blueacro/reefvolt-sensorbuddy/hardware/drycontact/docs/images/pcb-3d-bottom.png

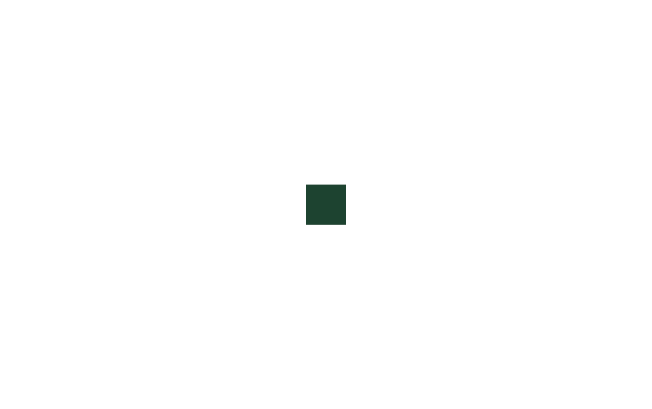
hardware/drycontact/docs/images/pcb-3d-bottom.png
