blueacro/reefvolt-sensorbuddy/hardware/drycontact/mcu.kicad_sch

## KiCad design hardware/drycontact/mcu.kicad_sch (2026-07-04)

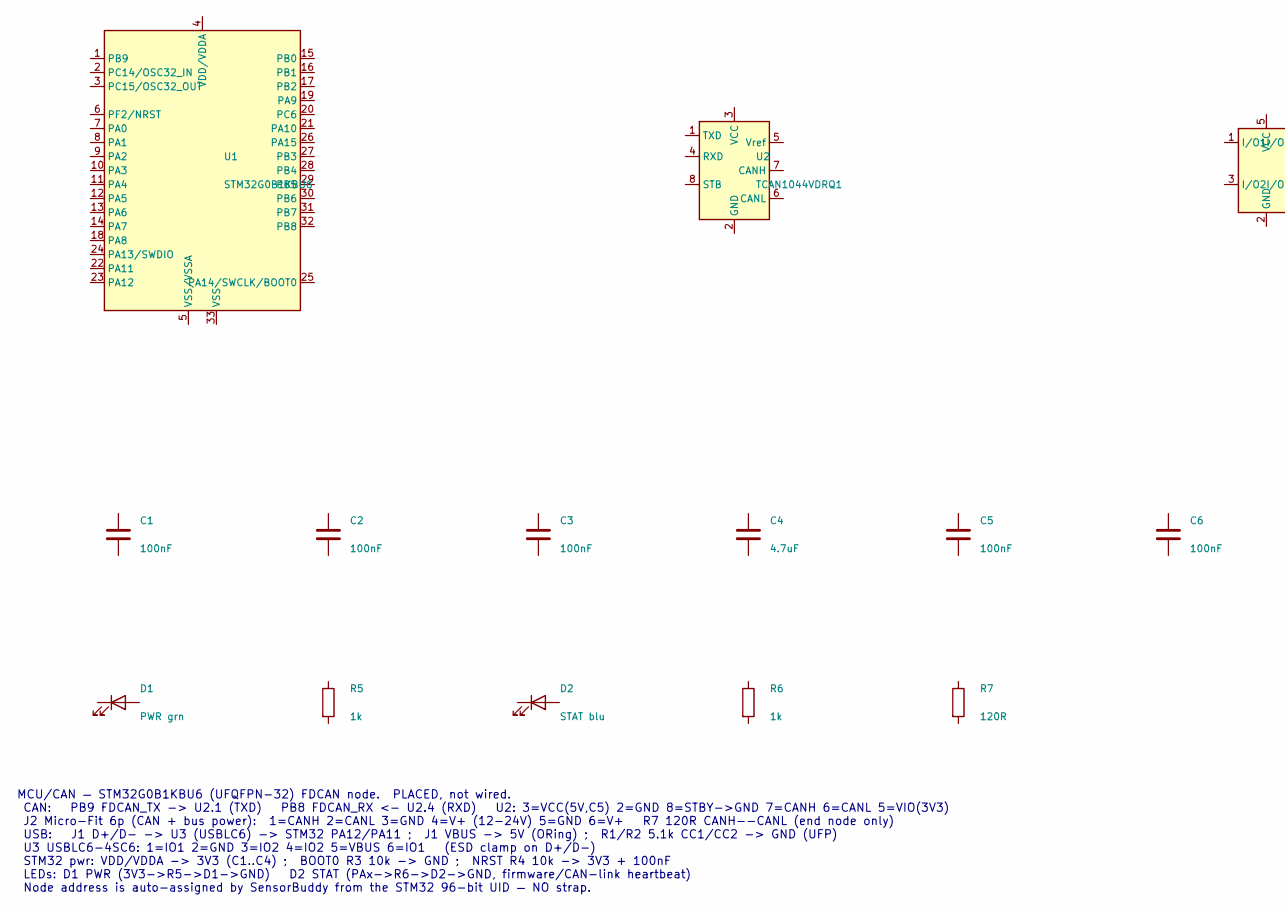
[picture p2: schematic mcu.kicad_sch, part in row 1, column 1]

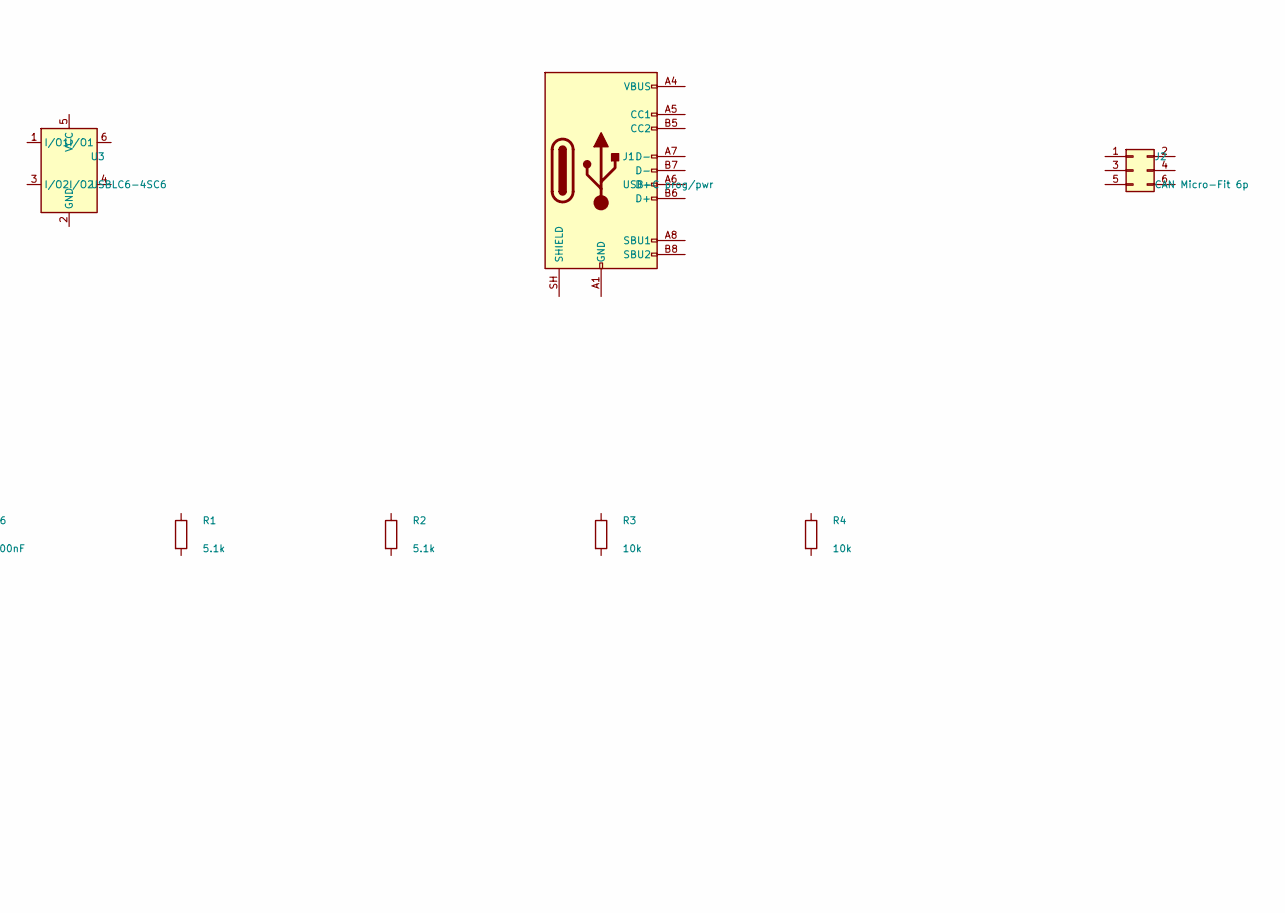
[picture p3: schematic mcu.kicad_sch, part in row 1, column 2]

Parts:
C1, C2, C3, C5, C6: 100nF; C_0402_1005Metric; LCSC C1525
C4: 4.7uF; C_0805_2012Metric; LCSC C1611
D1: PWR grn; LED_0402_1005Metric; MPN KT-0402G; LCSC C72043
D2: STAT blu; LED_0402_1005Metric; MPN KT-0402B; LCSC C72041
J1: USB-C prog/pwr; USB_C_Receptacle_HRO_TYPE-C-31-M-12; MPN TYPE-C-31-M-12; LCSC C165948
J2: CAN Micro-Fit 6p; Molex_Micro-Fit_3.0_43045-0612_2x03_P3.00mm_Vertical; MPN 43045-0612
R1, R2: 5.1k; R_0402_1005Metric; LCSC C27834
R3, R4: 10k; R_0402_1005Metric; LCSC C25744
R5, R6: 1k; R_0402_1005Metric; LCSC C11702
R7: 120R; R_0402_1005Metric
U1: STM32G0B1KBU6; UFQFPN-32; MPN STM32G0B1KBU6N; LCSC C5159549
U2: TCAN1044VDRQ1; SOIC-8_3.9x4.9mm_P1.27mm; MPN TCAN1044VDRQ1; LCSC C1852061
U3: USBLC6-4SC6; SOT-23-6; MPN USBLC6-4SC6; LCSC C5197386

Connections:
unnamed: J1.A1 (GND), J1.A12 (GND), J1.B1 (GND), J1.B12 (GND)
unnamed: J1.A4 (VBUS), J1.A9 (VBUS), J1.B4 (VBUS), J1.B9 (VBUS)

Notes on the sheet:
MCU/CAN — STM32G0B1KBU6 (UFQFPN-32) FDCAN node. PLACED, not wired. CAN: PB9 FDCAN_TX -> U2.1 (TXD) PB8 FDCAN_RX <- U2.4 (RXD) U2: 3=VCC(5V,C5) 2=GND 8=STBY->GND 7=CANH 6=CANL 5=VIO(3V3) J2 Micro-Fit 6p (CAN + bus power): 1=CANH 2=CANL 3=GND 4=V+ (12-24V) 5=GND 6=V+ R7 120R CANH--CANL (end node only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
