blueacro/reefvolt-sensorbuddy/hardware/drycontact/psu.kicad_sch

## KiCad design hardware/drycontact/psu.kicad_sch (2026-07-04)

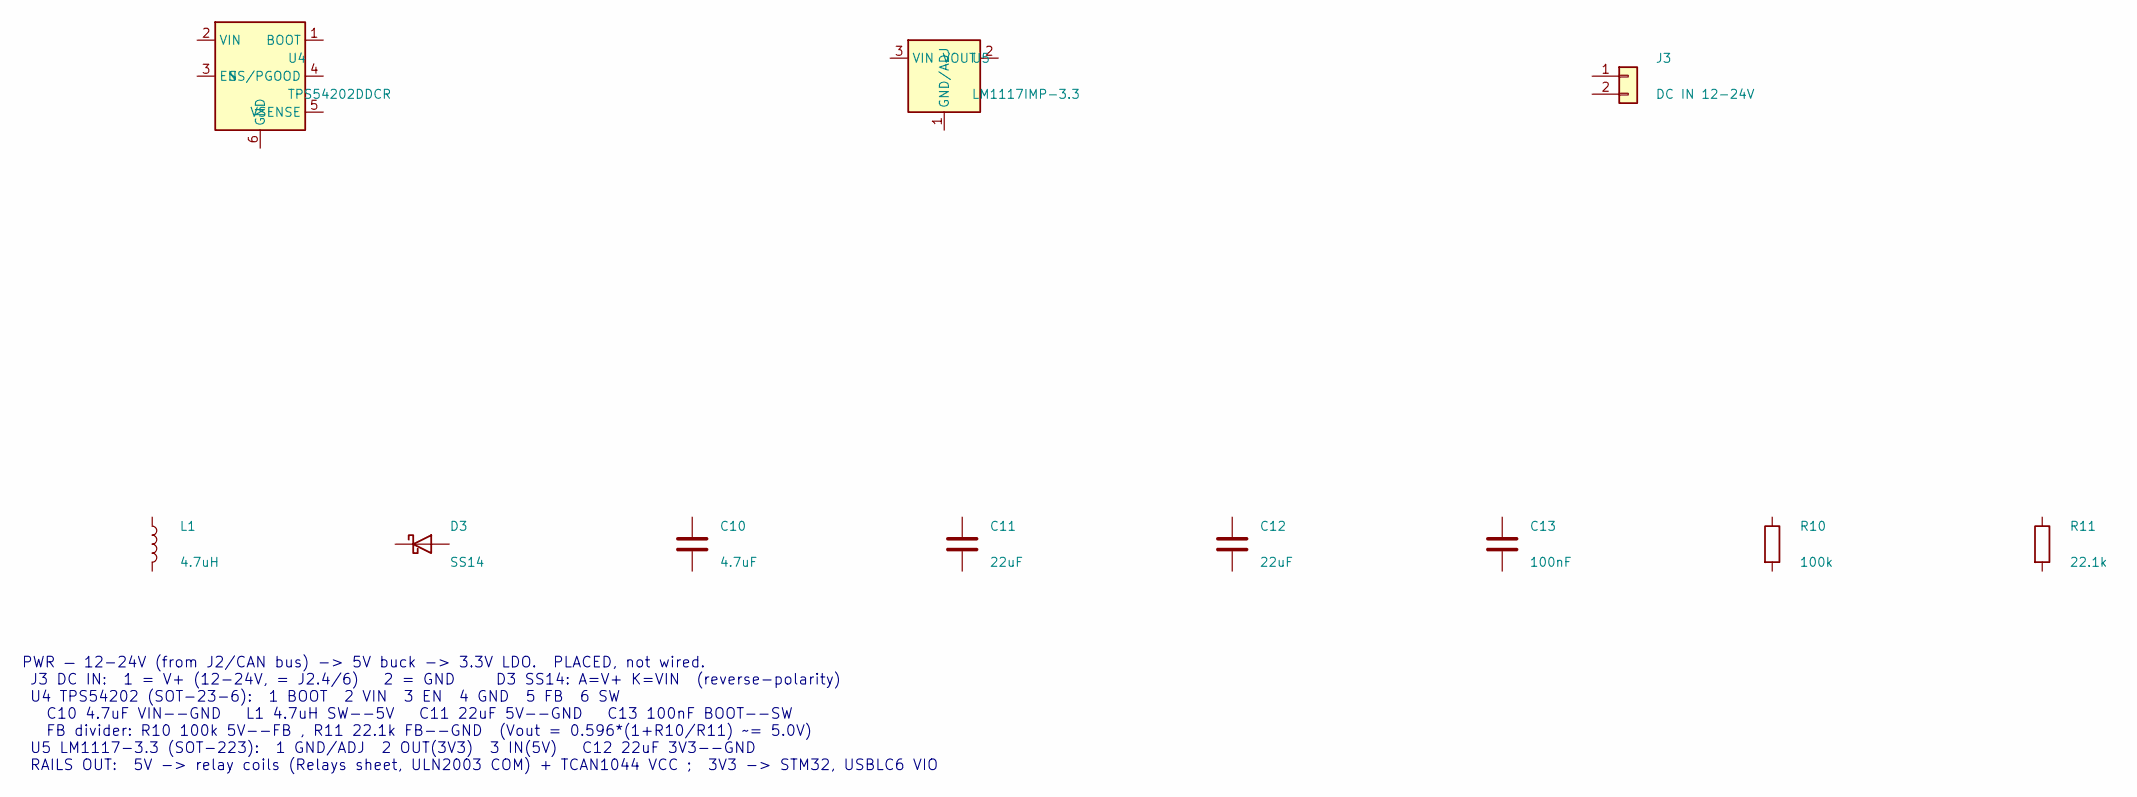
[picture p4: schematic psu.kicad_sch]

Parts:
C10: 4.7uF; C_1210_3225Metric; LCSC C1611
C11, C12: 22uF; C_1210_3225Metric; LCSC C45783
C13: 100nF; C_0402_1005Metric; LCSC C1525
D3: SS14; D_SMA; MPN SS14; LCSC C2480
J3: DC IN 12-24V; TerminalBlock_Phoenix_MPT-0,5-2-2.54_1x02_P2.54mm_Horizontal; MPN MPT-0,5/2-2,54
L1: 4.7uH; L_Bourns-SRN4018; MPN SRN4018-4R7M; LCSC C408412
R10: 100k; R_0402_1005Metric; LCSC C25741
R11: 22.1k; R_0402_1005Metric; LCSC C25765
U4: TPS54202DDCR; SOT-23-6; MPN TPS54202DDCR; LCSC C191884
U5: LM1117IMP-3.3; SOT-223-3_TabPin2; MPN LM1117IMPX-3.3/NOPB; LCSC C23984

Connections:
unnamed: U5.2 (VOUT), U5.4 (VOUT)

Notes on the sheet:
PWR — 12-24V (from J2/CAN bus) -> 5V buck -> 3.3V LDO. PLACED, not wired. J3 DC IN: 1 = V+ (12-24V, = J2.4/6) 2 = GND D3 SS14: A=V+ K=VIN (reverse-polarity) U4 TPS54202 (SOT-23-6): 1 BOOT 2 VIN 3 EN 4 GND 5 FB 6 SW C10 4.7uF VIN--GND L1 4.7uH SW--5V C11 22uF 5V--GND C13 100nF BOOT--SW FB divider: R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
