blueacro/reefvolt-sensorbuddy/hardware/drycontact/relays.kicad_sch

## KiCad design hardware/drycontact/relays.kicad_sch (2026-07-04)

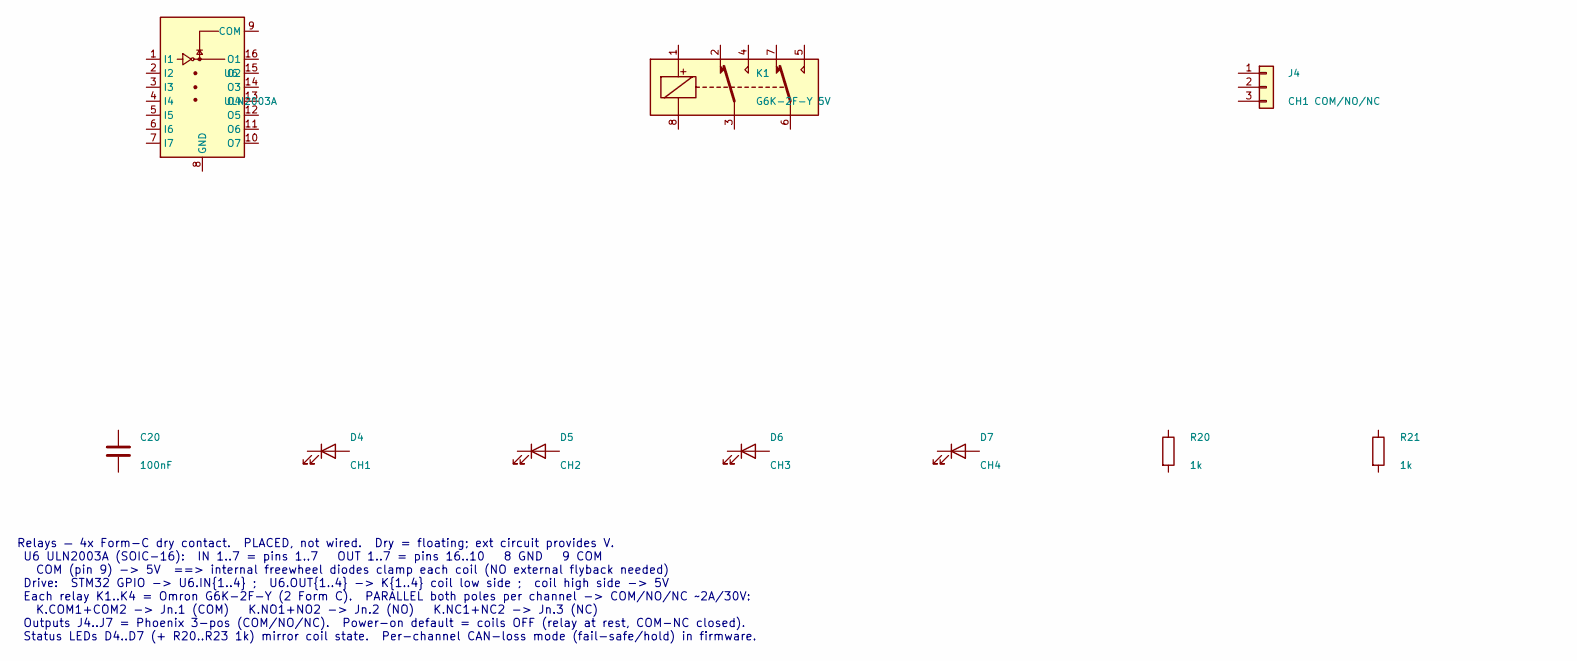
[picture p5: schematic relays.kicad_sch, part in row 1, column 1]

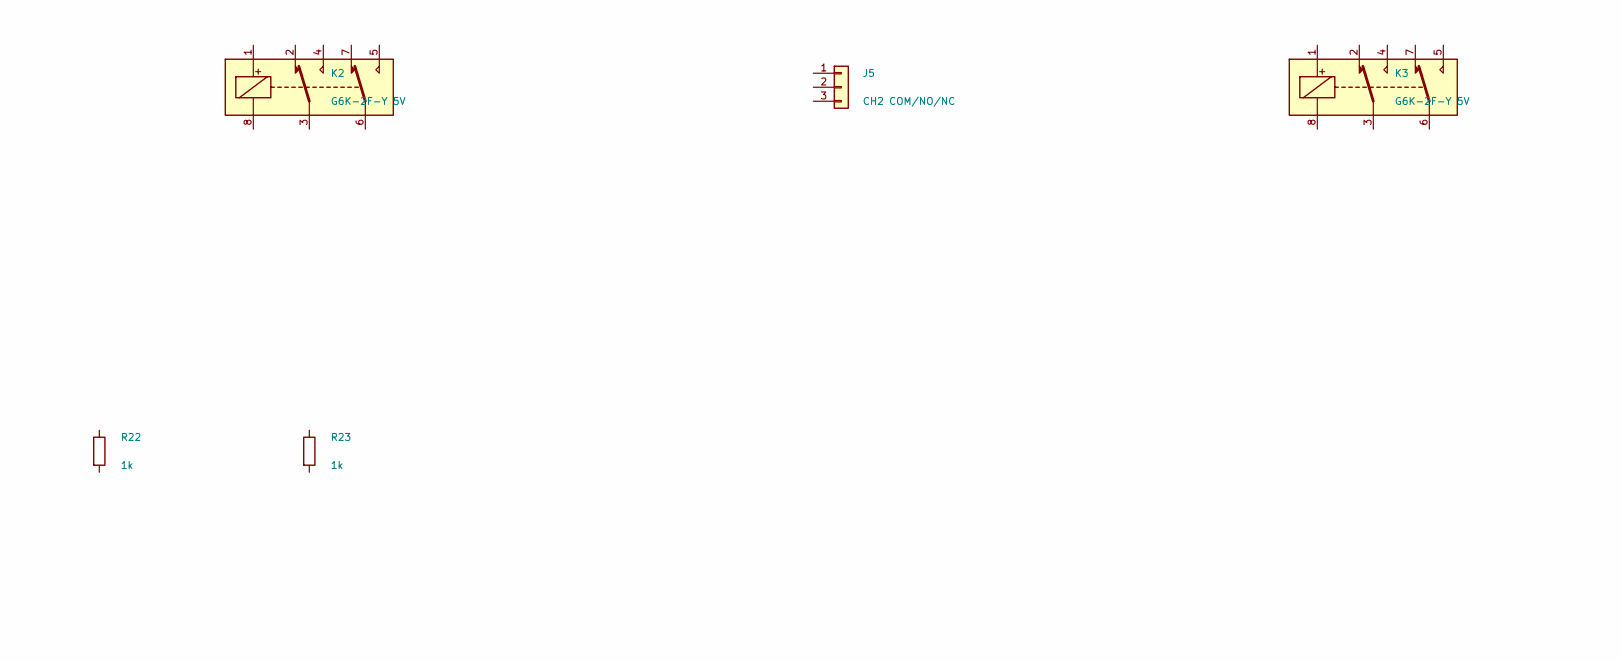
[picture p6: schematic relays.kicad_sch, part in row 1, column 2]

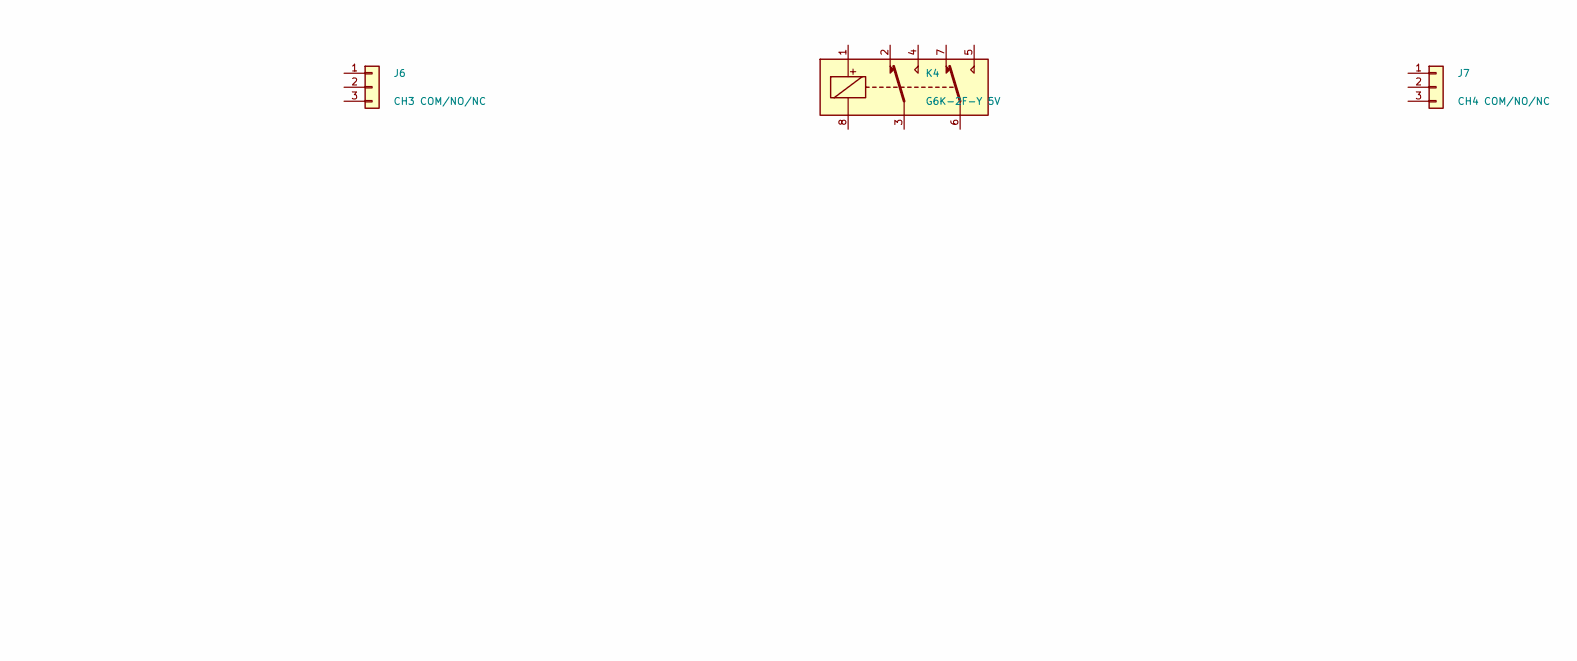
[picture p7: schematic relays.kicad_sch, part in row 1, column 3]

Parts:
C20: 100nF; C_0402_1005Metric; LCSC C1525
D4: CH1; LED_0402_1005Metric; MPN KT-0402B; LCSC C72041
D5: CH2; LED_0402_1005Metric; MPN KT-0402B; LCSC C72041
D6: CH3; LED_0402_1005Metric; MPN KT-0402B; LCSC C72041
D7: CH4; LED_0402_1005Metric; MPN KT-0402B; LCSC C72041
J4: CH1 COM/NO/NC; TerminalBlock_Phoenix_MPT-0,5-3-2.54_1x03_P2.54mm_Horizontal; MPN MPT-0,5/3-2,54
J5: CH2 COM/NO/NC; TerminalBlock_Phoenix_MPT-0,5-3-2.54_1x03_P2.54mm_Horizontal; MPN MPT-0,5/3-2,54
J6: CH3 COM/NO/NC; TerminalBlock_Phoenix_MPT-0,5-3-2.54_1x03_P2.54mm_Horizontal; MPN MPT-0,5/3-2,54
J7: CH4 COM/NO/NC; TerminalBlock_Phoenix_MPT-0,5-3-2.54_1x03_P2.54mm_Horizontal; MPN MPT-0,5/3-2,54
K1, K2, K3, K4: G6K-2F-Y 5V; Relay_DPDT_Omron_G6K-2F-Y; MPN G6K-2F-Y DC5; LCSC C47190
R20, R21, R22, R23: 1k; R_0402_1005Metric; LCSC C11702
U6: ULN2003A; SOIC-16_3.9x9.9mm_P1.27mm; MPN ULN2003ADR; LCSC C7512

Notes on the sheet:
Relays — 4x Form-C dry contact. PLACED, not wired. Dry = floating; ext circuit provides V. U6 ULN2003A (SOIC-16): IN 1..7 = pins 1..7 OUT 1..7 = pins 16..10 8 GND 9 COM COM (pin 9) -> 5V ==> internal freewheel diodes clamp each coil (NO external flyback needed) Drive: STM32 GPIO -> U6.IN{1..4} ; U6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
