blueacro/reefvolt-sensorbuddy/hardware/plugcontrol/actuation.kicad_sch

## KiCad design hardware/plugcontrol/actuation.kicad_sch (2026-07-04)

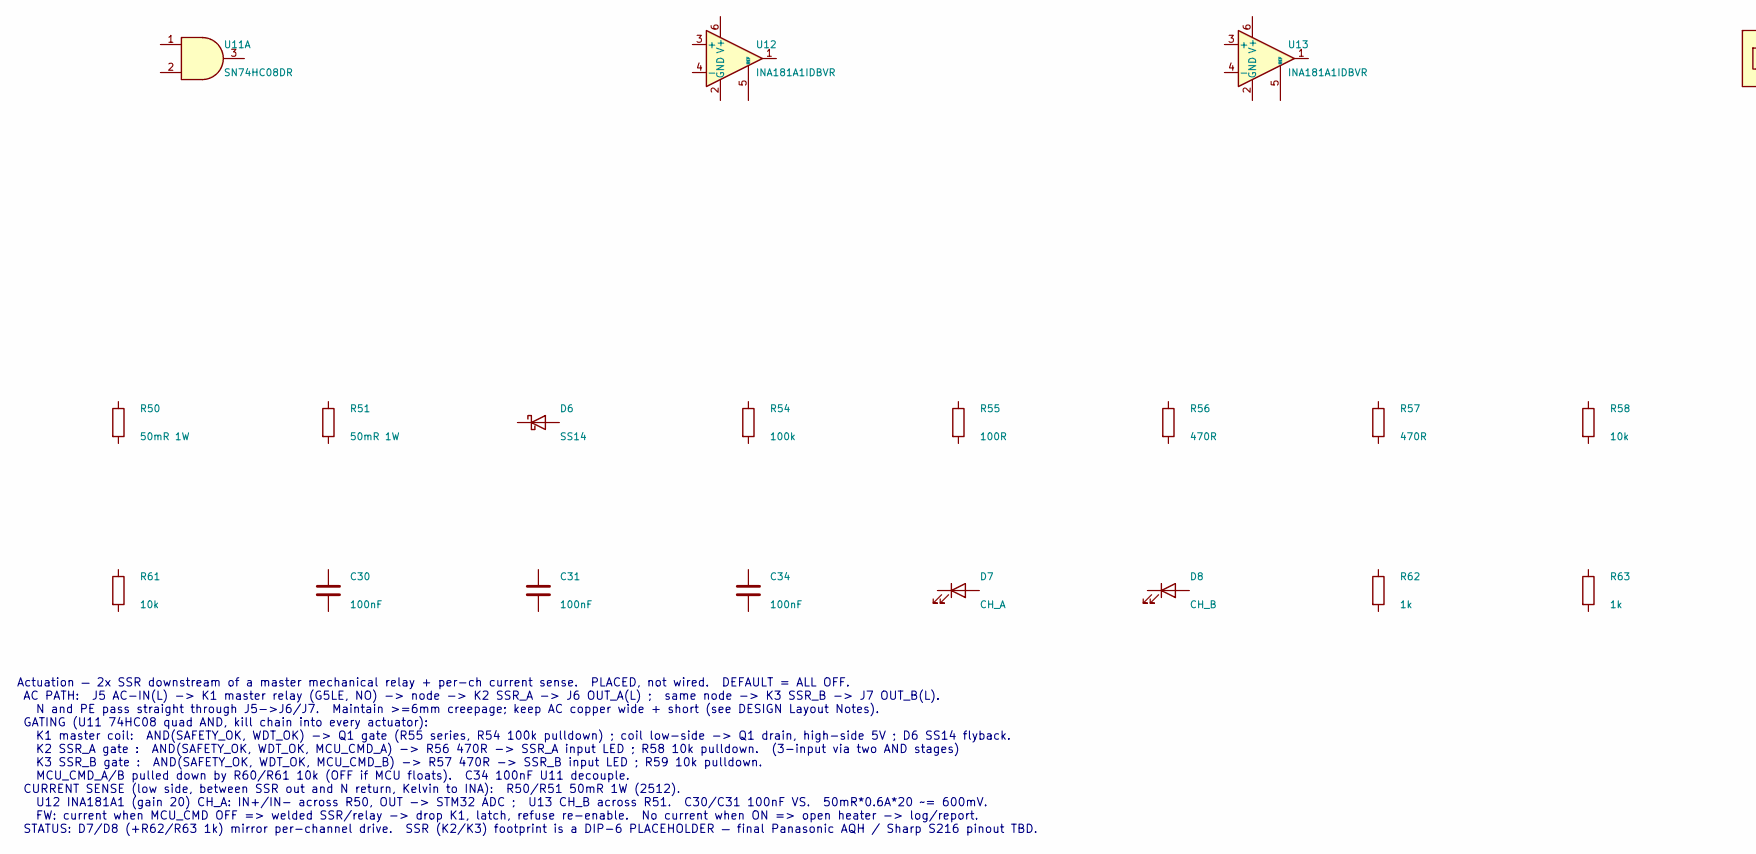
[picture p8: schematic actuation.kicad_sch, part in row 1, column 1]

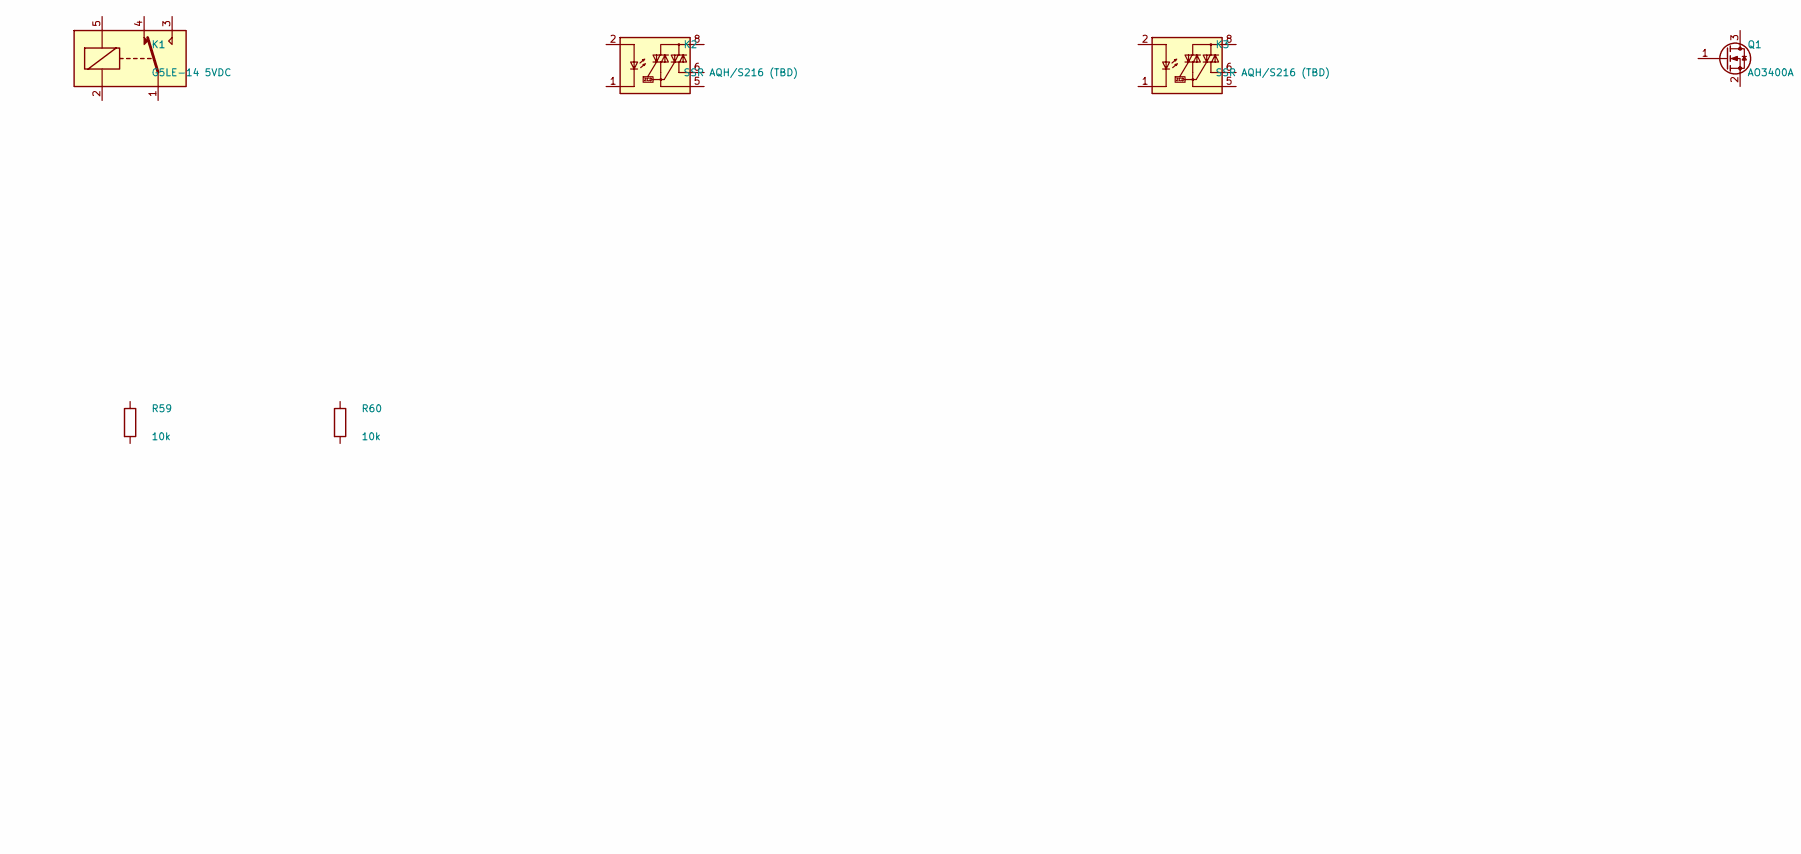
[picture p9: schematic actuation.kicad_sch, part in row 1, column 2]

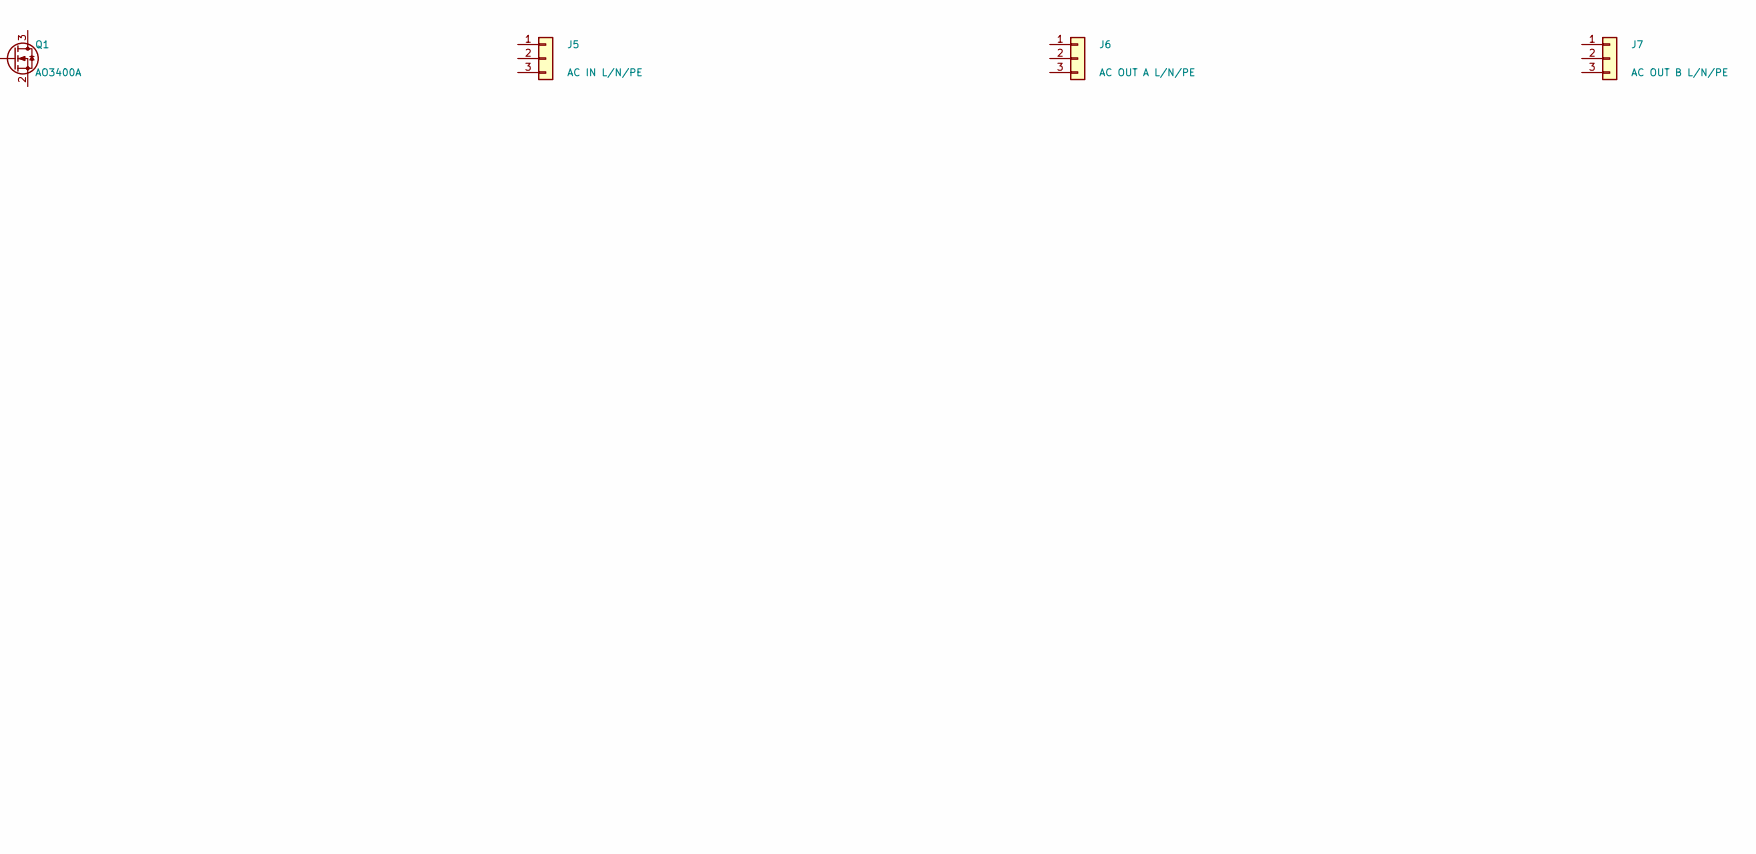
[picture p10: schematic actuation.kicad_sch, part in row 1, column 3]

Parts:
C30, C31, C34: 100nF; C_0402_1005Metric; LCSC C1525
D6: SS14; D_SMA; MPN SS14; LCSC C2480
D7: CH_A; LED_0402_1005Metric; MPN KT-0402B; LCSC C72041
D8: CH_B; LED_0402_1005Metric; MPN KT-0402B; LCSC C72041
J5: AC IN L/N/PE; TerminalBlock_Phoenix_MKDS-1,5-3-5.08_1x03_P5.08mm_Horizont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; MPN MKDS-1,5/3-5,08
J6: AC OUT A L/N/PE; TerminalBlock_Phoenix_MKDS-1,5-3-5.08_1x03_P5.08mm_Horizont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; MPN MKDS-1,5/3-5,08
J7: AC OUT B L/N/PE; TerminalBlock_Phoenix_MKDS-1,5-3-5.08_1x03_P5.08mm_Horizont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; MPN MKDS-1,5/3-5,08
K1: G5LE-14 5VDC; Relay_SPDT_Omron-G5LE-1; MPN G5LE-14 DC5; LCSC C116963
K2, K3: SSR AQH/S216 (TBD); DIP-6_W7.62mm; MPN AQH0213 / S216S02
Q1: AO3400A; SOT-23; MPN AO3400A; LCSC C20917
R50, R51: 50mR 1W; R_2512_6332Metric
R54: 100k; R_0402_1005Metric; LCSC C25741
R55: 100R; R_0402_1005Metric; LCSC C106232
R56, R57: 470R; R_0402_1005Metric
R58, R59, R60, R61: 10k; R_0402_1005Metric; LCSC C25744
R62, R63: 1k; R_0402_1005Metric; LCSC C11702
U11: SN74HC08DR; SOIC-14_3.9x8.7mm_P1.27mm; MPN SN74HC08DR; LCSC C337768
U12, U13: INA181A1IDBVR; SOT-23-6; MPN INA181A1IDBVR; LCSC C2058943

Connections:
unnamed: K2.1, K2.3, K2.4
unnamed: K3.1, K3.3, K3.4

Notes on the sheet:
Actuation — 2x SSR downstream of a master mechanical relay + per-ch current sense. PLACED, not wired. DEFAULT = ALL OFF. AC PATH: J5 AC-IN(L) -> K1 master relay (G5LE, NO) -> node -> K2 SSR_A -> J6 OUT_A(L) ; same node -> K3 SSR_B -> J7 OUT_B(L). N and PE pass straight through J5->J6/J7. Maintain >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
