blueacro/reefvolt-sensorbuddy/hardware/plugcontrol/mcu.kicad_sch

## KiCad design hardware/plugcontrol/mcu.kicad_sch (2026-07-04)

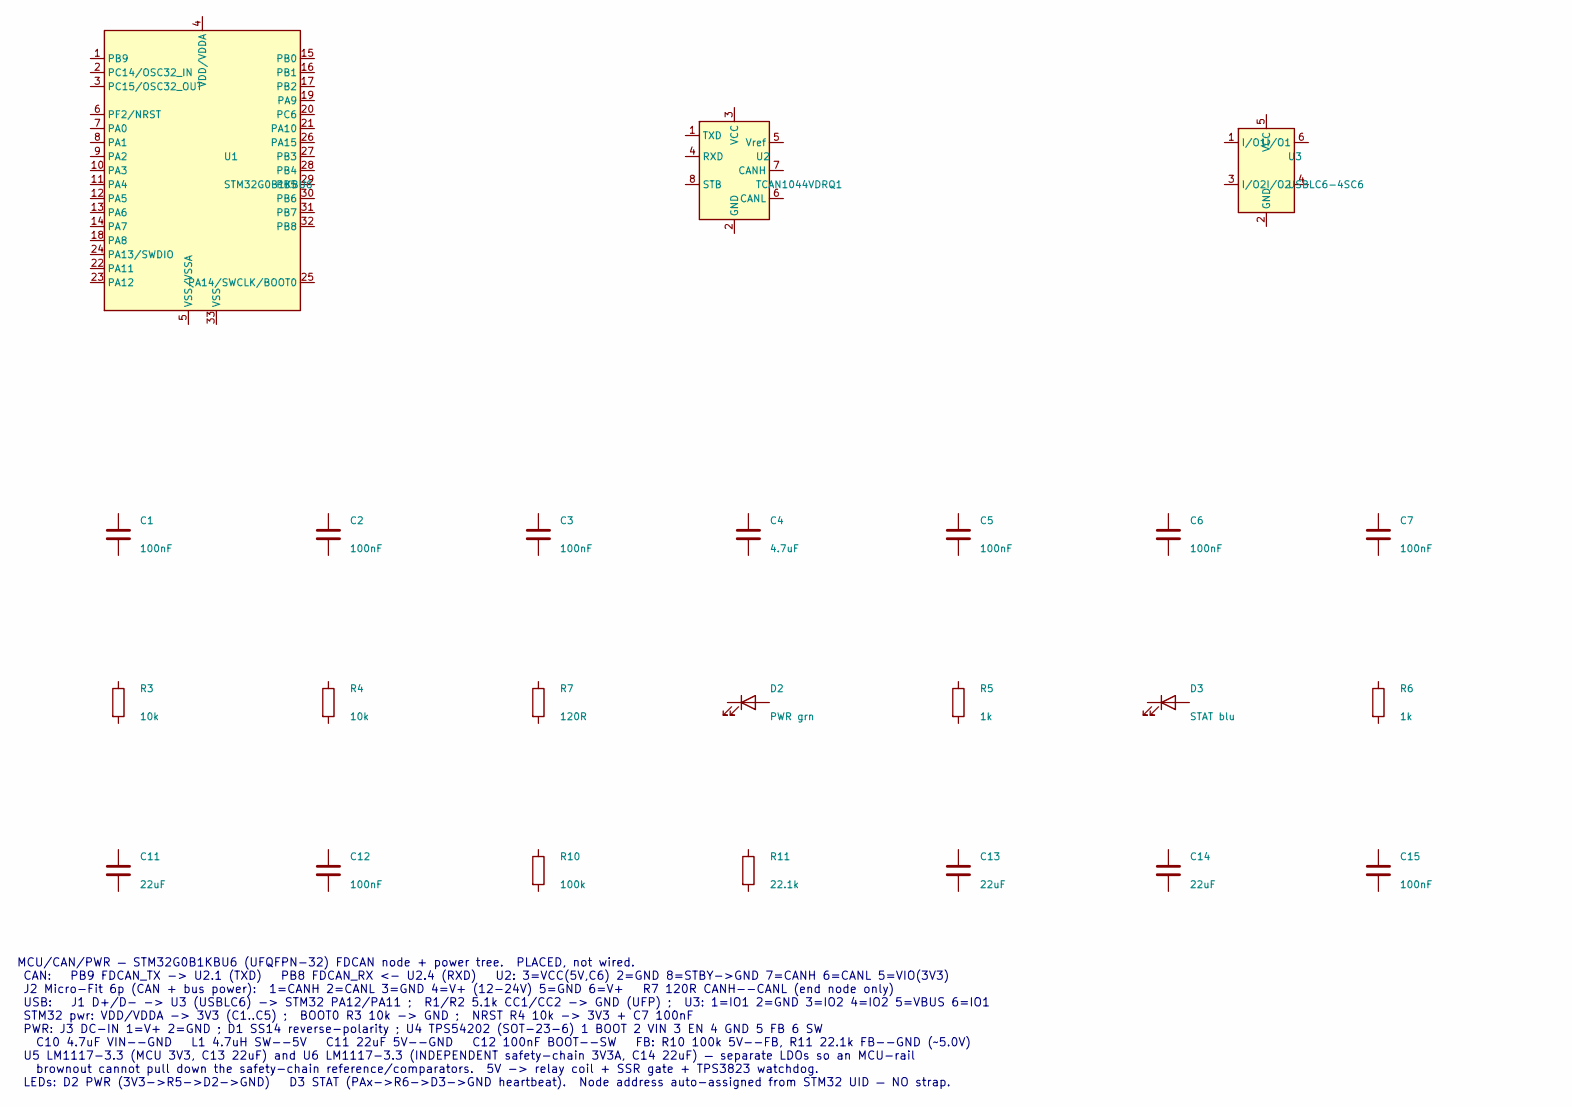
[picture p11: schematic mcu.kicad_sch, part in row 1, column 1]

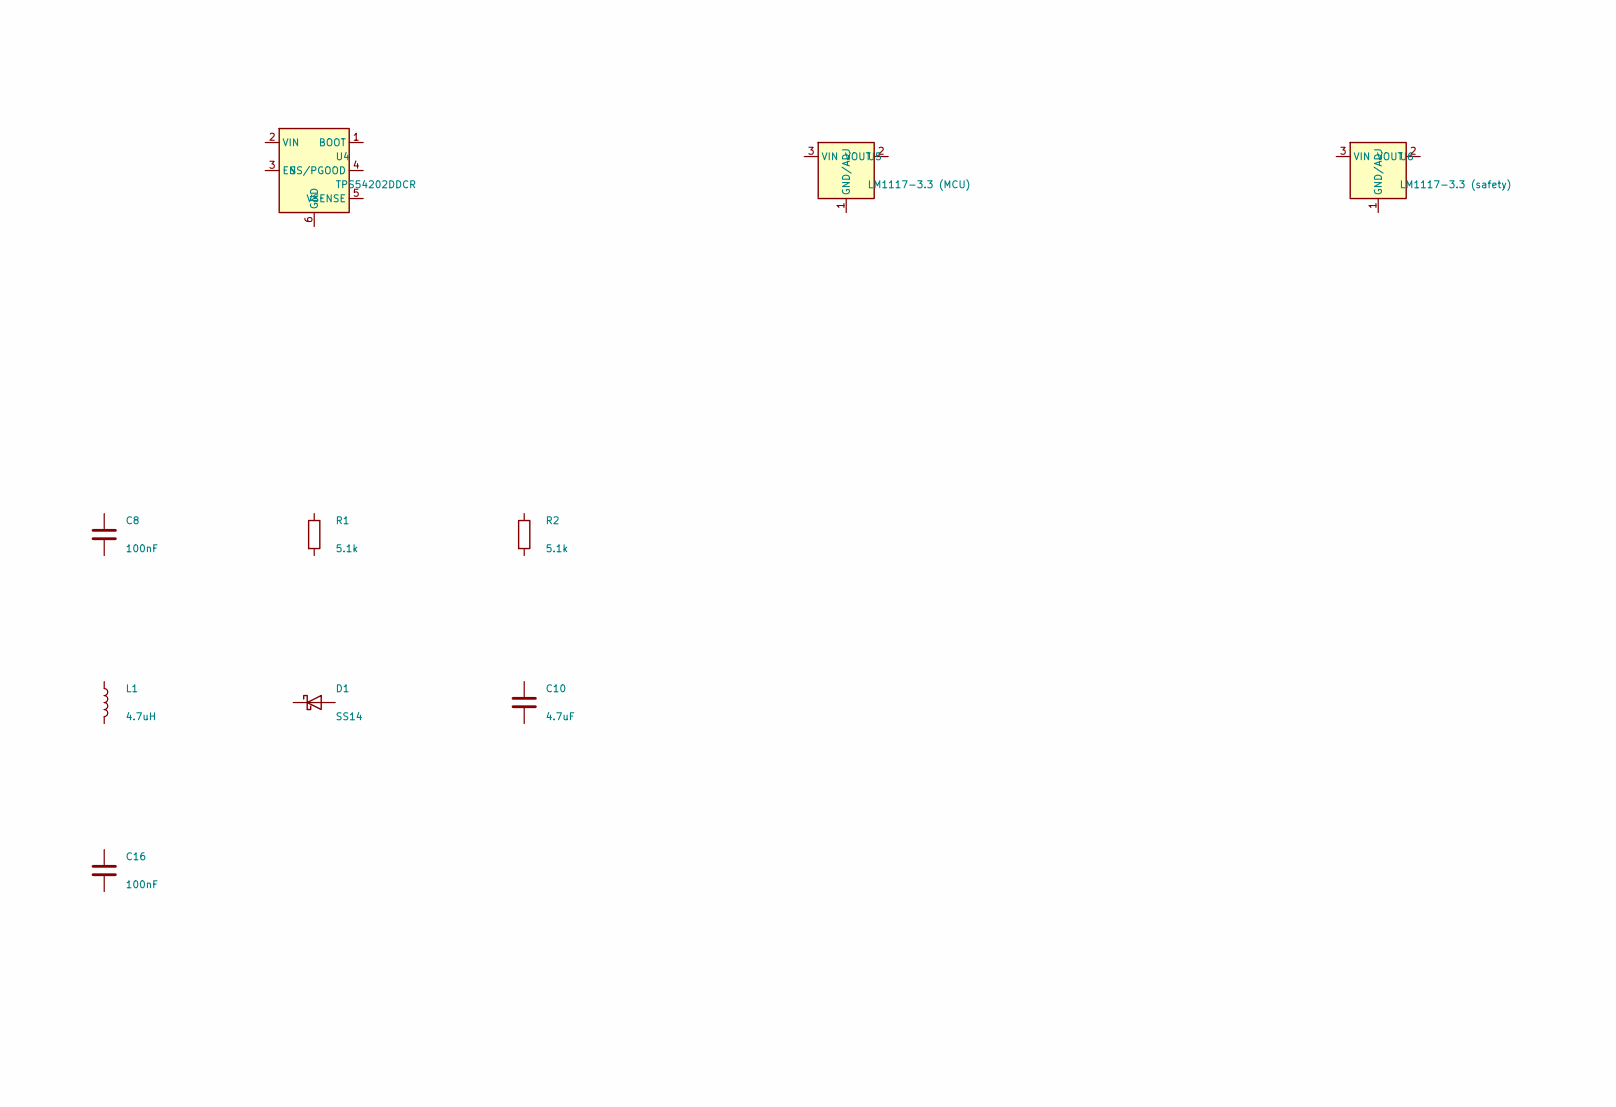
[picture p12: schematic mcu.kicad_sch, part in row 1, column 2]

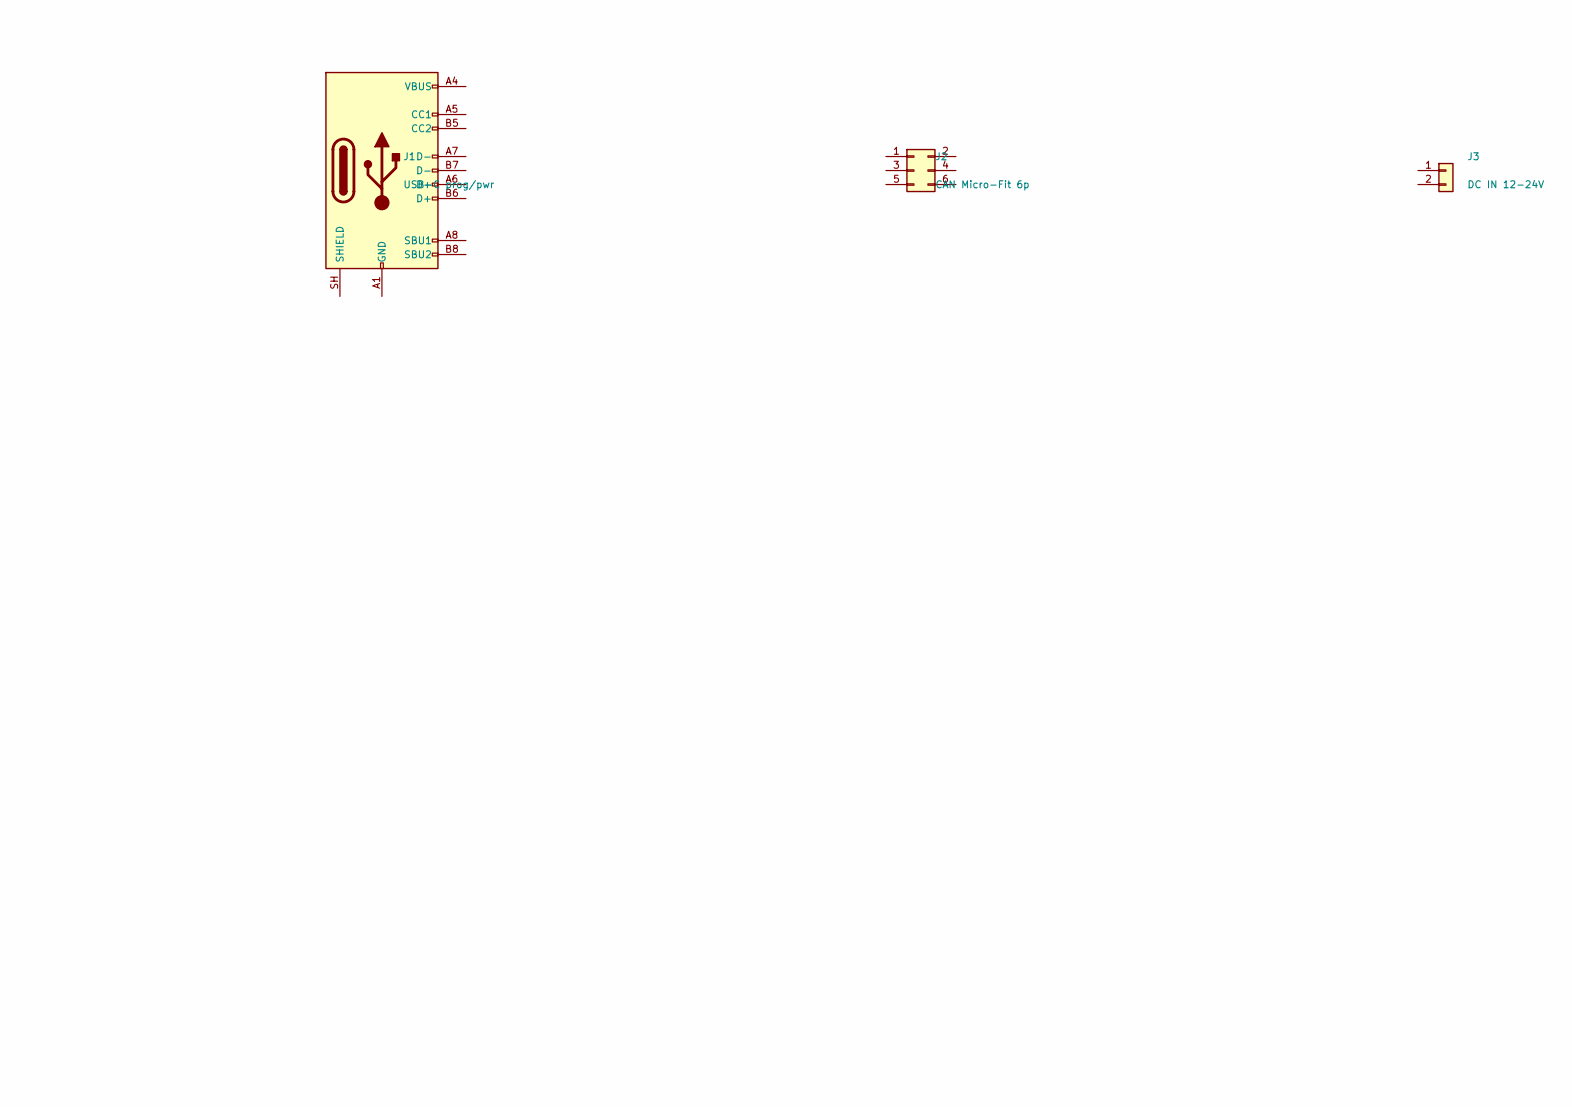
[picture p13: schematic mcu.kicad_sch, part in row 1, column 3]

Parts:
C1, C2, C3, C5, C6, C7, C8, C12, C15, C16: 100nF; C_0402_1005Metric; LCSC C1525
C4: 4.7uF; C_0805_2012Metric; LCSC C1611
C10: 4.7uF; C_1210_3225Metric; LCSC C1611
C11, C13, C14: 22uF; C_1210_3225Metric; LCSC C45783
D1: SS14; D_SMA; MPN SS14; LCSC C2480
D2: PWR grn; LED_0402_1005Metric; MPN KT-0402G; LCSC C72043
D3: STAT blu; LED_0402_1005Metric; MPN KT-0402B; LCSC C72041
J1: USB-C prog/pwr; USB_C_Receptacle_HRO_TYPE-C-31-M-12; MPN TYPE-C-31-M-12; LCSC C165948
J2: CAN Micro-Fit 6p; Molex_Micro-Fit_3.0_43045-0612_2x03_P3.00mm_Vertical; MPN 43045-0612
J3: DC IN 12-24V; TerminalBlock_Phoenix_MPT-0,5-2-2.54_1x02_P2.54mm_Horizontal; MPN MPT-0,5/2-2,54
L1: 4.7uH; L_Bourns-SRN4018; MPN SRN4018-4R7M; LCSC C408412
R1, R2: 5.1k; R_0402_1005Metric; LCSC C27834
R3, R4: 10k; R_0402_1005Metric; LCSC C25744
R5, R6: 1k; R_0402_1005Metric; LCSC C11702
R7: 120R; R_0402_1005Metric
R10: 100k; R_0402_1005Metric; LCSC C25741
R11: 22.1k; R_0402_1005Metric; LCSC C25765
U1: STM32G0B1KBU6; UFQFPN-32; MPN STM32G0B1KBU6N; LCSC C5159549
U2: TCAN1044VDRQ1; SOIC-8_3.9x4.9mm_P1.27mm; MPN TCAN1044VDRQ1; LCSC C1852061
U3: USBLC6-4SC6; SOT-23-6; MPN USBLC6-4SC6; LCSC C5197386
U4: TPS54202DDCR; SOT-23-6; MPN TPS54202DDCR; LCSC C191884
U5: LM1117-3.3 (MCU); SOT-223-3_TabPin2; MPN LM1117IMPX-3.3/NOPB; LCSC C23984
U6: LM1117-3.3 (safety); SOT-223-3_TabPin2; MPN LM1117IMPX-3.3/NOPB; LCSC C23984

Connections:
unnamed: J1.A1 (GND), J1.A12 (GND), J1.B1 (GND), J1.B12 (GND)
unnamed: J1.A4 (VBUS), J1.A9 (VBUS), J1.B4 (VBUS), J1.B9 (VBUS)
unnamed: U5.2 (VOUT), U5.4 (VOUT)
unnamed: U6.2 (VOUT), U6.4 (VOUT)

Notes on the sheet:
MCU/CAN/PWR — STM32G0B1KBU6 (UFQFPN-32) FDCAN node + power tree. PLACED, not wired. CAN: PB9 FDCAN_TX -> U2.1 (TXD) PB8 FDCAN_RX <- U2.4 (RXD) U2: 3=VCC(5V,C6) 2=GND 8=STBY->GND 7=CANH 6=CANL 5=VIO(3V3) J2 Micro-Fit 6p (CAN + bus power): 1=CANH 2=CANL 3=GND 4=V+ (12-24V) 5=GND 6=V+ R7 120R CANH--CA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
