blueacro/reefvolt-sensorbuddy/hardware/plugcontrol/safety.kicad_sch

## KiCad design hardware/plugcontrol/safety.kicad_sch (2026-07-04)

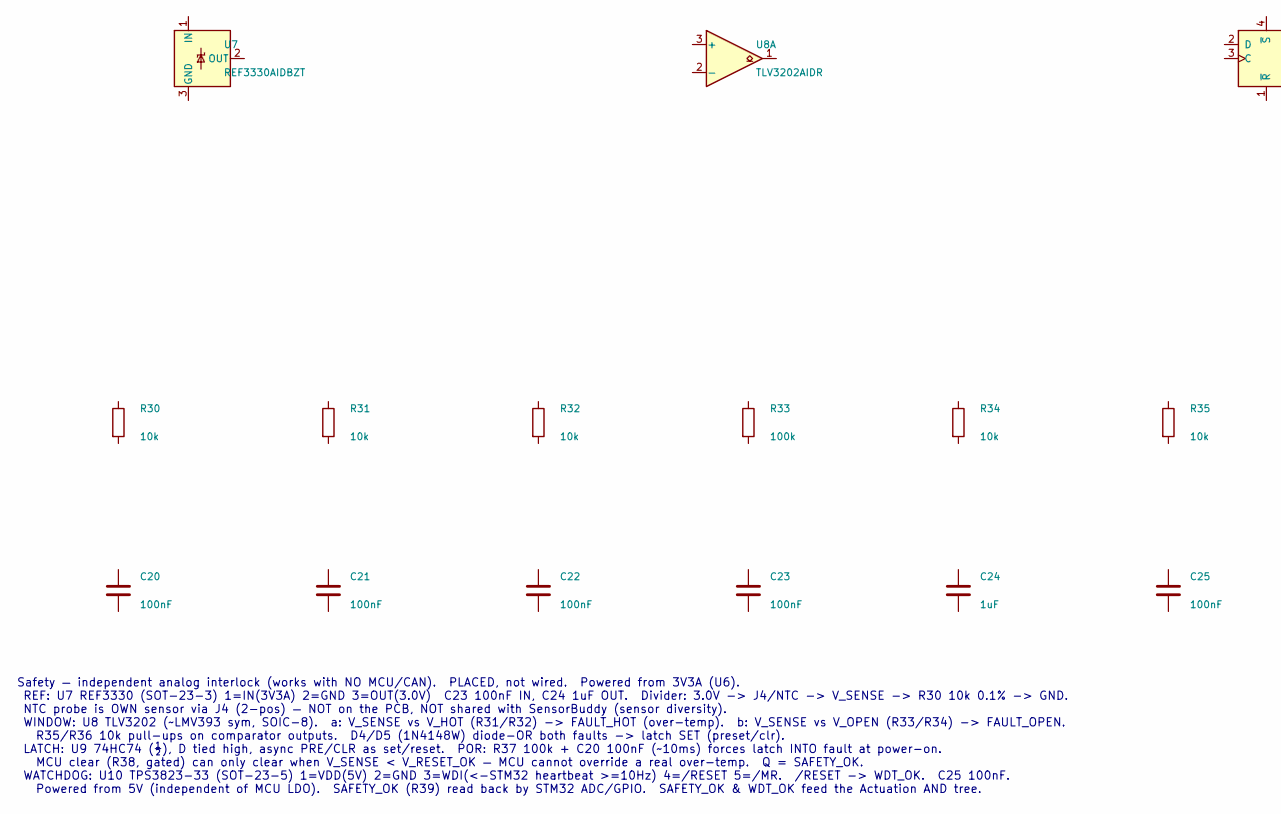
[picture p14: schematic safety.kicad_sch, part in row 1, column 1]

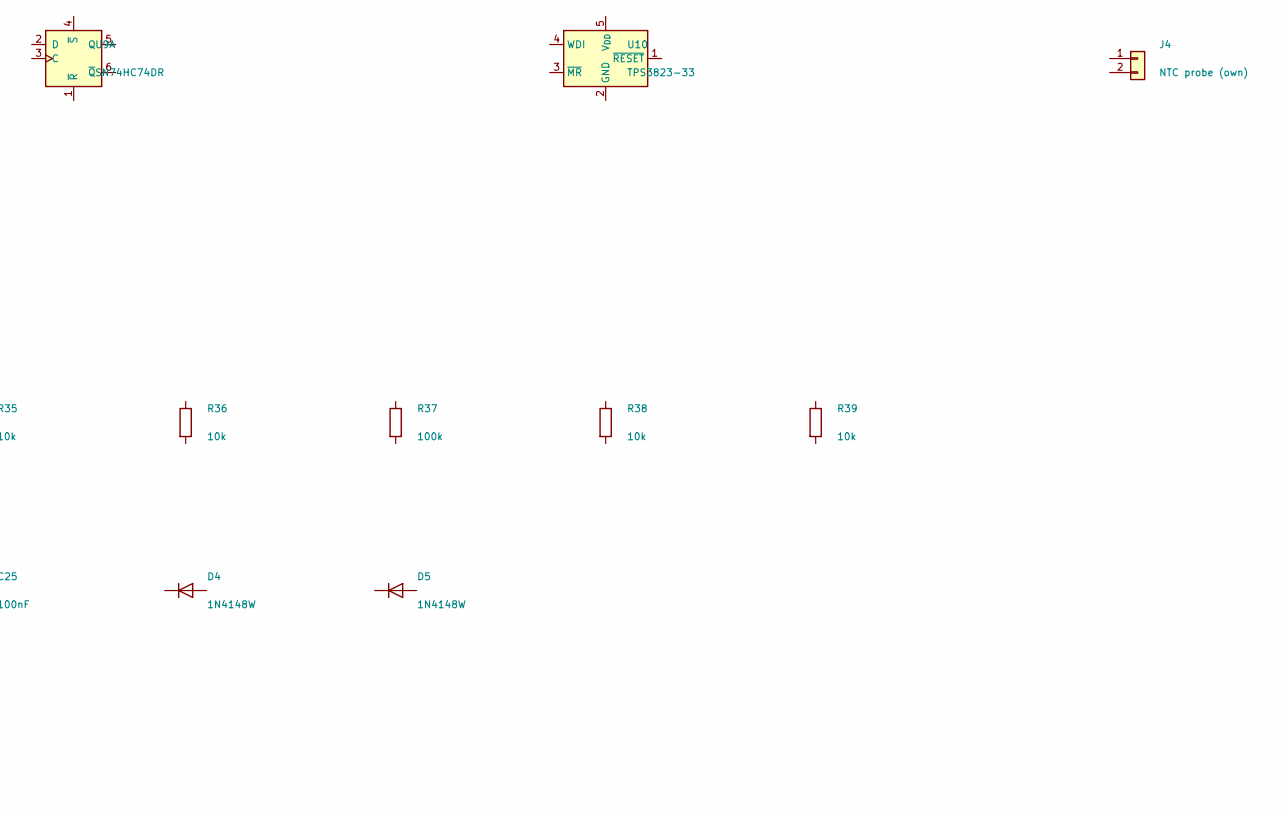
[picture p15: schematic safety.kicad_sch, part in row 1, column 2]

Parts:
C20, C21, C22, C23, C25: 100nF; C_0402_1005Metric; LCSC C1525
C24: 1uF; C_0402_1005Metric; LCSC C29266
D4, D5: 1N4148W; D_SOD-123; MPN 1N4148W; LCSC C81598
J4: NTC probe (own); TerminalBlock_Phoenix_MPT-0,5-2-2.54_1x02_P2.54mm_Horizontal; MPN MPT-0,5/2-2,54
R30, R31, R32, R34: 10k; R_0603_1608Metric; LCSC C25744
R33: 100k; R_0603_1608Metric; LCSC C25741
R35, R36, R38, R39: 10k; R_0402_1005Metric; LCSC C25744
R37: 100k; R_0402_1005Metric; LCSC C25741
U7: REF3330AIDBZT; SOT-23; MPN REF3330AIDBZT; LCSC C2156496
U8: TLV3202AIDR; SOIC-8_3.9x4.9mm_P1.27mm; MPN TLV3202AIDR; LCSC C129325
U9: SN74HC74DR; SOIC-14_3.9x8.7mm_P1.27mm; MPN SN74HC74DR; LCSC C6762
U10: TPS3823-33; SOT-23-5; MPN TPS3823-33DBVR; LCSC C7719

Notes on the sheet:
Safety — independent analog interlock (works with NO MCU/CAN). PLACED, not wired. Powered from 3V3A (U6). REF: U7 REF3330 (SOT-23-3) 1=IN(3V3A) 2=GND 3=OUT(3.0V) C23 100nF IN, C24 1uF OUT. Divider: 3.0V -> J4/NTC -> V_SENSE -> R30 10k 0.1% -> GND. NTC probe is OWN sensor via J4 (2-pos) — NOT on the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
