blueacro/reefvolt-sensorbuddy/hardware/sensorbuddy/main.kicad_sch

## KiCad design hardware/sensorbuddy/main.kicad_sch (2026-07-04)

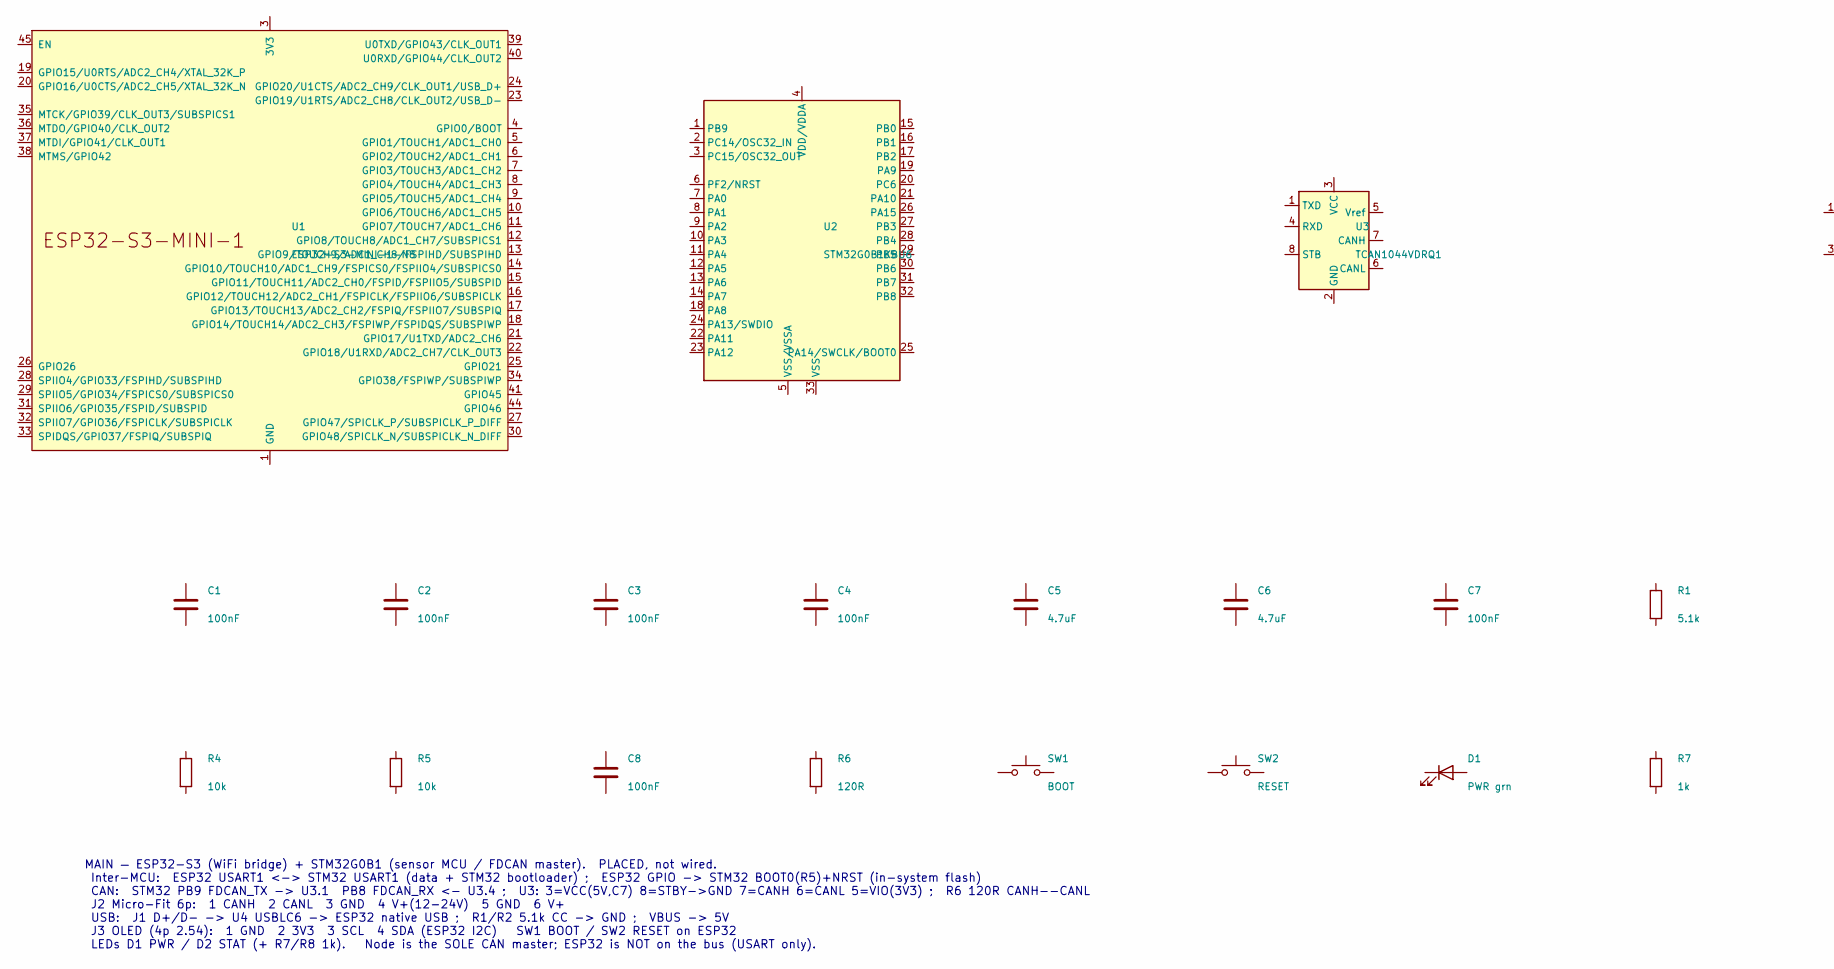
[picture p16: schematic main.kicad_sch, part in row 1, column 1]

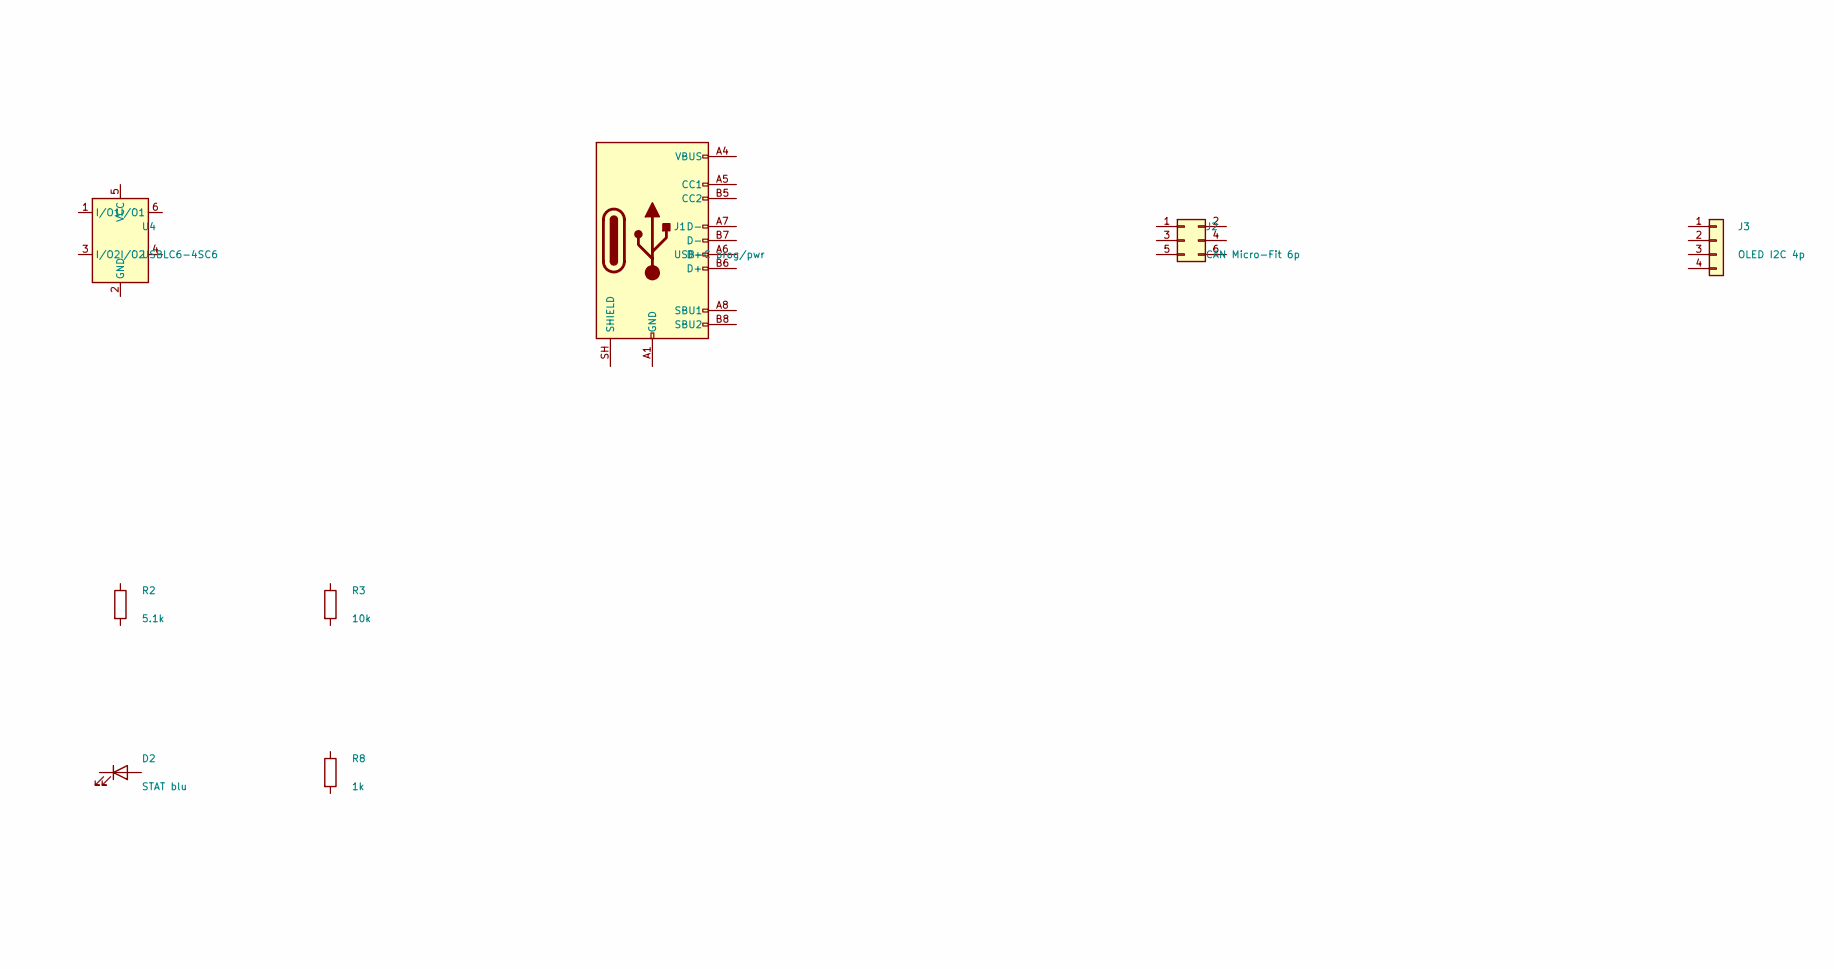
[picture p17: schematic main.kicad_sch, part in row 1, column 2]

Parts:
C1, C2, C3, C4, C7, C8: 100nF; C_0603_1608Metric; LCSC C14663
C5, C6: 4.7uF; C_0805_2012Metric; LCSC C19666
D1: PWR grn; LED_0603_1608Metric; MPN KT-0603; LCSC C72043
D2: STAT blu; LED_0603_1608Metric; MPN KT-0603; LCSC C72041
J1: USB-C prog/pwr; USB_C_Receptacle_HRO_TYPE-C-31-M-12; MPN TYPE-C-31-M-12; LCSC C165948
J2: CAN Micro-Fit 6p; Molex_Micro-Fit_3.0_43045-0612_2x03_P3.00mm_Vertical; MPN 43045-0612
J3: OLED I2C 4p; PinHeader_1x04_P2.54mm_Vertical; MPN 0901471104
R1, R2: 5.1k; R_0402_1005Metric; LCSC C27834
R3, R4, R5: 10k; R_0603_1608Metric; LCSC C25804
R6: 120R; C_1210_3225Metric; LCSC C22787
R7, R8: 1k; R_0603_1608Metric; LCSC C21190
SW1: BOOT; SW_Push_1P1T_NO_CK_KMR2; MPN PTS526; LCSC C318884
SW2: RESET; SW_Push_1P1T_NO_CK_KMR2; MPN PTS526; LCSC C318884
U1: ESP32-S3-MINI-1-N8; ESP32-S3-MINI-1; MPN ESP32-S3-MINI-1-N8; LCSC C2913204
U2: STM32G0B1KBU6; UFQFPN-32; MPN STM32G0B1KBU6N; LCSC C5159549
U3: TCAN1044VDRQ1; SOIC-8_3.9x4.9mm_P1.27mm; MPN TCAN1044VDRQ1; LCSC C1852061
U4: USBLC6-4SC6; SOT-23-6; MPN USBLC6-4SC6; LCSC C5197386

Connections:
unnamed: J1.A1 (GND), J1.A12 (GND), J1.B1 (GND), J1.B12 (GND)
unnamed: J1.A4 (VBUS), J1.A9 (VBUS), J1.B4 (VBUS), J1.B9 (VBUS)
unnamed: U1.1 (GND), U1.2 (GND), U1.42 (GND), U1.43 (GND), U1.46 (GND), U1.47 (GND), U1.48 (GND), U1.49 (GND), U1.50 (GND), U1.51 (GND), U1.52 (GND), U1.53 (GND), U1.54 (GND), U1.55 (GND), U1.56 (GND), U1.57 (GND), U1.58 (GND), U1.59 (GND), U1.60 (GND), U1.61 (GND), U1.62 (GND), U1.63 (GND), U1.64 (GND), U1.65 (GND)

Notes on the sheet:
MAIN — ESP32-S3 (WiFi bridge) + STM32G0B1 (sensor MCU / FDCAN master). PLACED, not wired. Inter-MCU: ESP32 USART1 <-> STM32 USART1 (data + STM32 bootloader) ; ESP32 GPIO -> STM32 BOOT0(R5)+NRST (in-system flash) CAN: STM32 PB9 FDCAN_TX -> U3.1 PB8 FDCAN_RX <- U3.4 ; U3: 3=VCC(5V,C7) 8=STBY->GND 7=C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
