blueacro/reefvolt-sensorbuddy/(commit log)

2026-04-19 Initial project structure for reefvolt-sensorbuddy + plugcontrol
    Two-board system for aquarium sensor acquisition and heater control:
    - SensorBuddy: ESP32-S3 + STM32G0B1 sensor interface with isolated
    pH/ORP probes (ADM3260 + ADS1115), NTC thermistors, 1-Wire DS18B20,
    float switches, and FDCAN bus output
    - PlugControl: STM32G0B1 heater relay carrier with dual SSR + master
    relay, hardware analog safety chain (NTC + comparator + SR latch),
    watchdog, and per-channel current monitoring
    Includes KiCad 10 project skeleton, shared symbol/footprint libraries,
    JLCPCB packaging script, and Makefile from tsumikoro.
2026-04-19 Flesh out SensorBuddy power supply, probe front-end, and sensor details
    Power supply: TPS54202 buck (12-24V → 5V) + LM1117 LDO (5V → 3.3V),
    with ADM3260 isoPower for isolated probe domain. Full component values
    and topology documented.
    Isolated probe front-end: MAX9637 dual unity-gain buffer for high-Z
    pH/ORP probes, feeding ADS1115 differential ADC. Mid-rail bias divider
    for common-mode centering. Architecture validated against reefpi-pico
    pH module (SVG reference added).
    NTC/1-Wire/float switch front-ends detailed with component values,
    filtering, ESD protection, and connector assignments (Phoenix COMBICON).
    Complete BOM with LCSC stock levels for all active parts.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
2026-04-19 Add KiCad schematic sheets, symbol library, footprints, and 3D models
    Symbol library (9 ICs): STM32G0B1KBU6, ESP32-S3-MINI-1, TPS54202DDCR,
    LM1117IMP-3.3, TCAN1044VDRQ1, OPA2376AIDR, ADS1115IDGST, ADM3260ARSZ,
    USBLC6-4SC6. All with LCSC/MPN/Manufacturer properties and 0402 basic
    passives spec'd throughout.
    Footprints and STEP models copied from tsumikoro for UFQFPN-32 and
    ESP32-S3-MINI-1. Three schematic sheets (top-level + PSU + sensors
    subsheets) with title blocks and design notes. Blank 4-layer PCB.
    DESIGN.md updated: OPA2376AIDR replaces MAX9637 as probe buffer (dual
    opamp, better availability, adequate specs). LwOW 1-Wire library added
    as firmware dependency. Corrected MAX9637 single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
    [jlcpcb_bom.csv, psu.kicad_sch, sensorbuddy.kicad_pcb, sensorbuddy.kicad_sch, sensors.kicad_sch]
2026-07-04 hardware: sync KiCad/JLC toolchain from sibling projects
    Bring the hardware toolchain up to parity with ephemerkey/notchdeck/calcumaker:
    - jlcpcb-package.sh: drop exclude_from_bom footprints + mounting holes/fiducials
    from the CPL and add a <board>-handsolder.txt list, so the assembly BOM and CPL
    match (the old script produced CPLs JLCPCB rejects).
    - Makefile: PCB-optional image builds (guarded) + new gen-/check-/render- targets;
    add drycontact to PROJECTS.
    - Add kschgen.py schematic-generator engine + kicad-sch-check.py / kicad-sch-render.sh.
    - kschgen extract(): accept space- OR tab-indented .kicad_sym (this repo's custom
    symbol lib is space-indented; the tab-only regex could not f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
2026-07-04 hardware: place parts for DryContact, PlugControl, SensorBuddy
    Generate each board's schematic from a scripts/<board>.schgen.py manifest —
    every part resolves to a real KiCad symbol + matching footprint + 3D model + LCSC.
    Parts are PLACED, not wired (wire in eeschema; each sheet carries a pinout note).
    make check-<board> = structure sound for all three:
    - DryContact (NEW): 49 components — STM32G0B1 + TCAN1044 + ULN2003 + 4x Omron
    G6K-2F-Y Form-C dry contacts; 29-bit CAN, UID auto-address. + BOM + handsolder.
    - PlugControl (NEW KiCad project): 88 components — mcu/safety/actuation. A few
    generic stand-in symbols (TLV3202/74HC08/REF3330/TPS3823/SSR) pending swap;
    footprints/LCSC ar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
    [actuation.kicad_sch, drycontact.kicad_pcb, drycontact.kicad_sch, jlcpcb_bom.csv, main.kicad_sch, mcu.kicad_sch, plugcontrol.kicad_pcb, plugcontrol.kicad_sch]
2026-07-05 firmware: add reefvolt_can — shared 29-bit CAN message catalog
    The single source of truth for the SensorBuddy CAN cluster, linked by every
    board (SensorBuddy master, PlugControl, DryContact, future carriers).
    firmware/shared/reefvolt_can/ (modeled on tsumikoro_bus):
    - 29-bit J1939-style id: [PRIO 3][MSGID 8][DEST 8][SRC 8][rsvd 2]; priority
    falls out of CAN arbitration.
    - Dynamic UID-based addressing (no straps): STM32 96-bit UID -> stable CRC-32
    token; master assigns + persists token->address. Address-independent fail-safe.
    - Full message set (heartbeat, address req/assign/announce/reset, fault,
    node-status, drycontact cmd/state, heater cmd, safety-clear, current,
    temperature, con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
    [reefvolt_can.c, reefvolt_can.h]
