blueacro/reefvolt-sensorbuddy/(notices)

Notices in the files:
hardware/sensorbuddy/sensorbuddy.kicad_sch:
CERN-OHL-P v2 / Apache 2.0
